SantaClawzzz/100muundur/Muundur.pdf

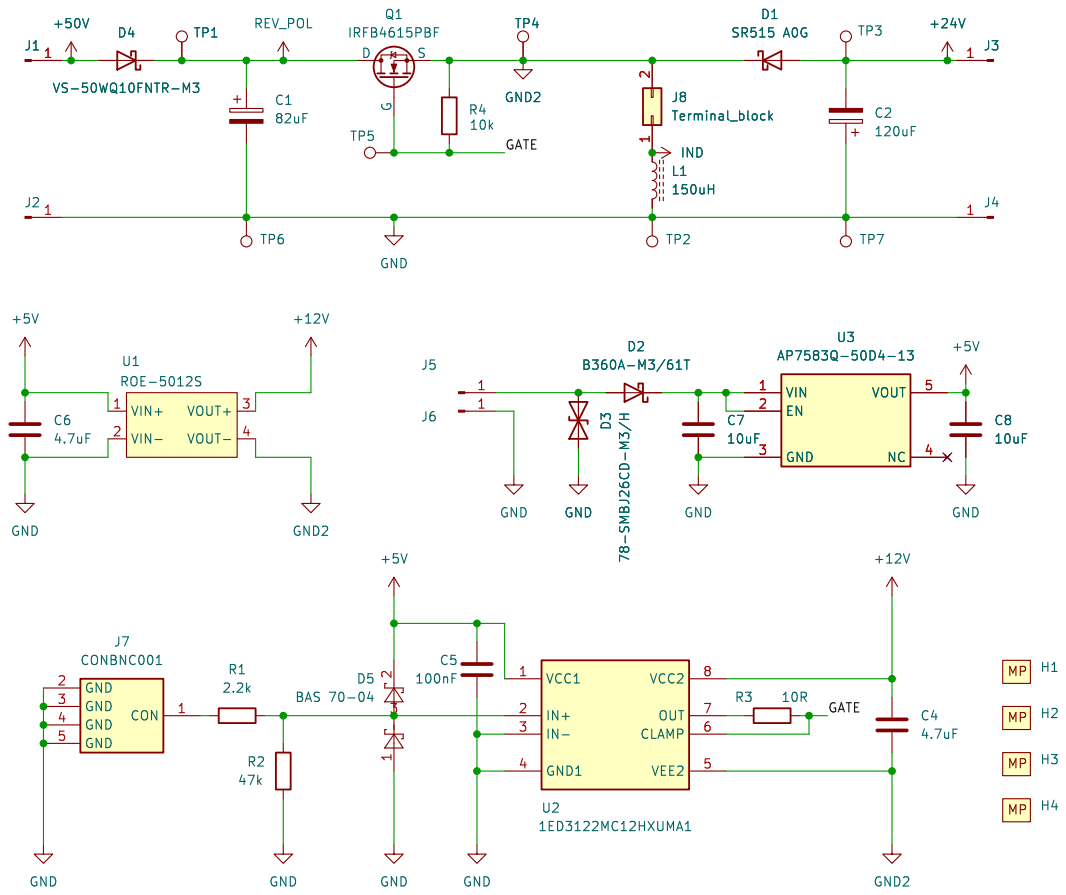
[picture p1: page 1]

Id: 1/1 Title: Pinge þÿtõste-langetus mundur 100kHz
