SantaClawzzz/100muundur/Muundur.kicad_pcb

## KiCad design Muundur.kicad_pcb (2026-05-22)

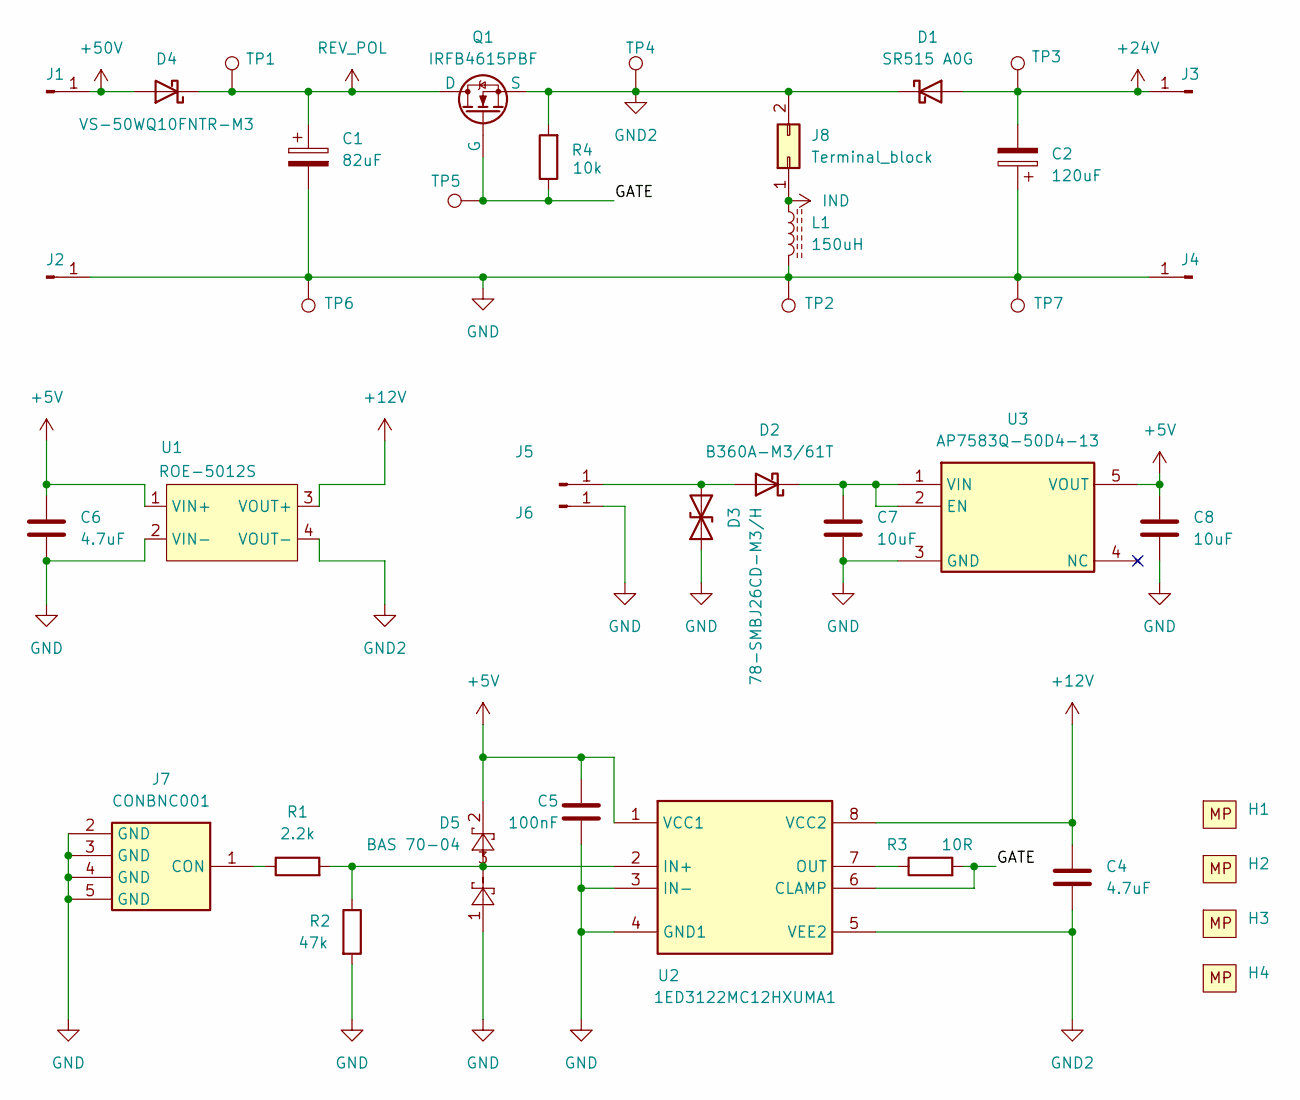
[picture p2: schematic Muundur.kicad_sch, Pinge tõste-langetus muundur 100kHz]

Parts:
C1: 82uF; 8mm CAP; MPN 80ZLJ82M8X20
C2: 120uF; 8mm CAP; MPN EEU-FM1H121LB
C4, C6: 4.7uF; C_1206_3216Metric_Pad1.33x1.80mm_HandSolder; MPN C1206C475K3PAC
C5: 100nF; C_1206_3216Metric_Pad1.33x1.80mm_HandSolder; MPN C1206C104K5RAC7210
C7: 10uF; C_1210_3225Metric_Pad1.33x2.70mm_HandSolder; MPN CL32B106KBJNNNE
C8: 10uF; C_1206_3216Metric_Pad1.33x1.80mm_HandSolder; MPN CL31B106KAHNNNE
D1: SR515 A0G; D_DO-201_P15.24mm_Horizontal; MPN SR515 A0G
D2: B360A-M3/61T; D_SMC; MPN B360A-M3/61T
D3: 78-SMBJ26CD-M3/H; D_SMA-SMB_Universal_Handsoldering; MPN 78-SMBJ26CD-M3/H
D4: VS-50WQ10FNTR-M3; TO-252.2; MPN VS-50WQ10FNTR-M3
D5: BAS 70-04; SOT-23; MPN BAS70-04
H1, H2, H3, H4: Standoff; MountingHole_4.3mm_M4; MPN 710-973150485
J1, J2, J3, J4, J5, J6: 5758; MPN 534-575-8
J7: CONBNC001; Mouser Part Number 712-CONBNC001
J8: Terminal_block; 1755736; MPN 1755736
L1: 150uH; 60B154C; MPN 60B154C
Q1: IRFB4615PBF; TO254P483X1016X1994-3P; MPN IRFB4615PBF
R1: 2.2k; R_1206_3216Metric_Pad1.30x1.75mm_HandSolder; MPN RC1206JR-132K2L
R2: 47k; R_1206_3216Metric_Pad1.30x1.75mm_HandSolder; MPN RC1206JR-1047KL
R3: 10R; R_1206_3216Metric_Pad1.30x1.75mm_HandSolder; MPN RK73B2BTTDD100J
R4: 10k; R_1206_3216Metric_Pad1.30x1.75mm_HandSolder; MPN RC1206FR-1310KL
TP1, TP2, TP3, TP4, TP5, TP6, TP7: TestPoint; TestPoint_THTPad_D1.5mm_Drill0.7mm
U1: ROE-5012S; ROE1205S; MPN ROE-5012S
U2: 1ED3122MC12HXUMA1; SOIC127P1030X265-8N; Mouser Part Number 726-D3122MC12HXUMA1
U3: AP7583Q-50D4-13; AP7583Q50D413; Mouser Part Number 621-AP7583Q-50D4-13

Connections:
+5V: C5.1, C6.1, C8.1, D5.2, U1.1 (VIN+), U2.1 (VCC1), U3.5 (VOUT)
+12V: C4.1, U1.3 (VOUT+), U2.8 (VCC2)
+24V: C2.2, D1.2 (A), J3.1, TP3.1
+50V: D4.2 (A), J1.1
/GATE: Q1.2 (G), R3.2, R4.1, TP5.1, U2.6 (CLAMP)
GND: C1.2, C2.1, C5.2, C6.2, C7.2, C8.2, D3.1 (A1), D5.1, J2.1, J4.1, J6.1, J7.2 (GND), J7.3 (GND), J7.4 (GND), J7.5 (GND), L1.2, R2.2, TP2.1, TP6.1, TP7.1, U1.2 (VIN-), U2.3 (IN-), U2.4 (GND1), U3.3 (GND)
GND2: C4.2, D1.1 (K), J8.2, Q1.3 (S), R4.2, TP4.1, U1.4 (VOUT-), U2.5 (VEE2)
IND: J8.1, L1.1
unnamed: D2.2 (A), D3.2 (A2), J5.1
unnamed: C7.1, D2.1 (K), U3.1 (VIN), U3.2 (EN)
unnamed: J7.1 (CON), R1.1
unnamed: D5.3, R1.2, R2.1, U2.2 (IN+)
unnamed: R3.1, U2.7 (OUT)
REV_POL: C1.1, D4.1 (K), Q1.1 (D), TP1.1

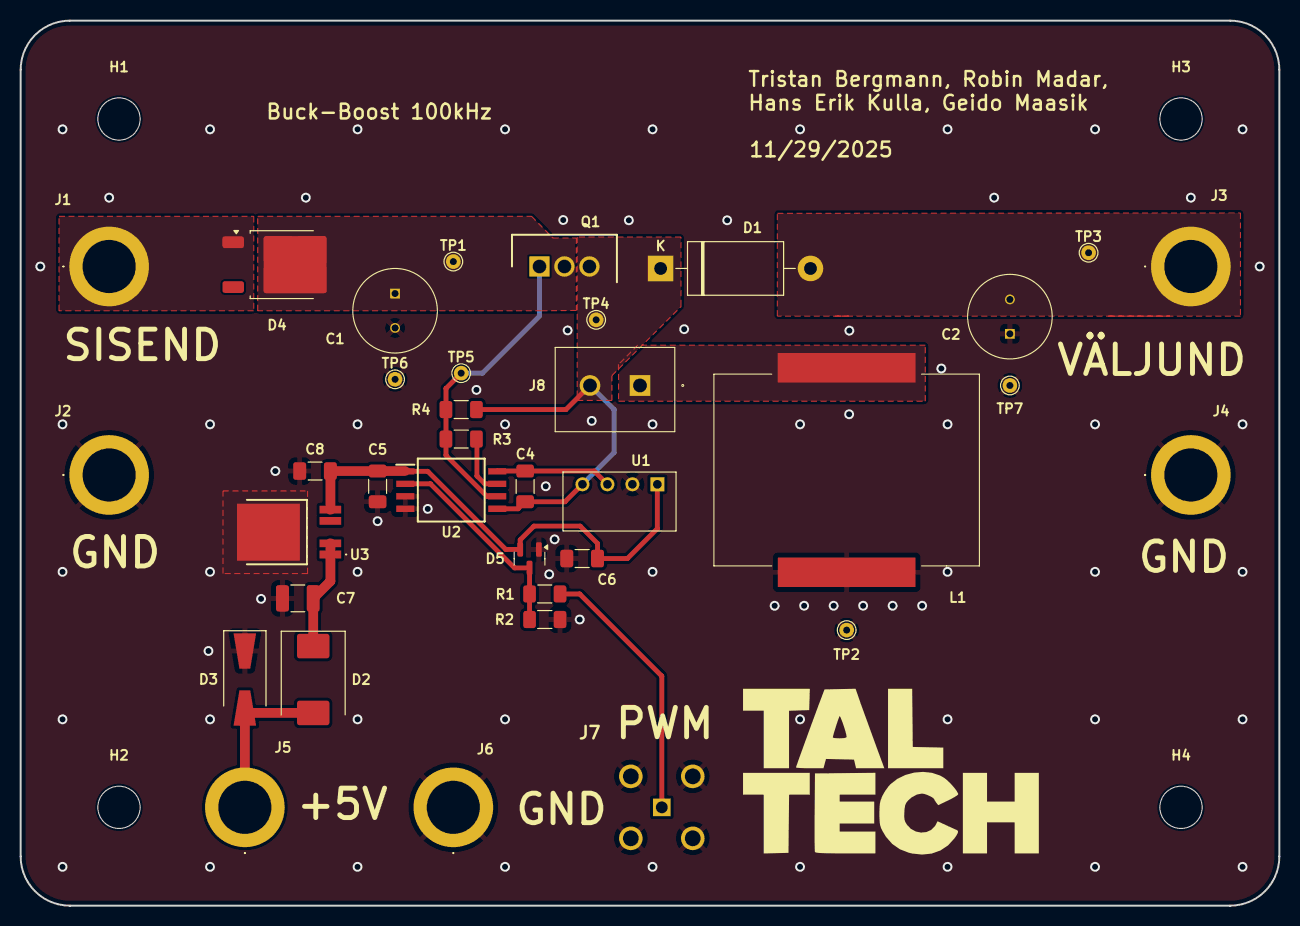
[picture p3: board Muundur.kicad_pcb from above]

Board: 2 copper layers, 128.0 x 90.0 mm, 40 parts (0 on the bottom side), 14 nets.
